nadahmed/IoTHomeAutomation/Report writing - Rough/pics/P_20171228_032329.jpg

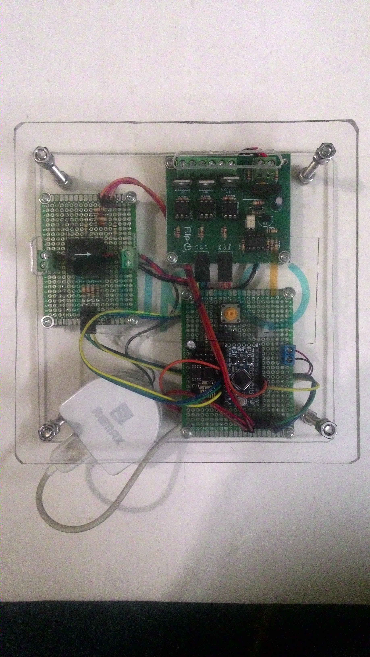
Report writing - Rough/pics/P_20171228_032329.jpg
