nadahmed/IoTHomeAutomation/499A/Project-Proposal-Updated (22nd Aug, 2017).docx

Department of Electrical and Computer Engineering

North South University

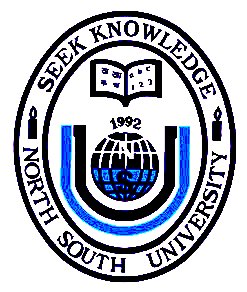
[picture p10: figure]

Senior Design Project

Home Automation System using Zero-Crossing detectors and Thyristor based Power Converter integrated with the world-wide-web and an Android app.

Noor Al Din Ahmed ID# 1310607043

Rahatul Aine ID # 1220812042

Faculty Advisor:

Tanzilur Rahman (Tnr)

EEE499A

Section: 05

Summer, 2017

Project Proposal

Title:

Home Automation System using Zero-Crossing detectors and Thyristor based Power Converter integrated with the world-wide-web and an Android app.

Abstract:

In today’s world everything is becoming modernized and almost everything is being controlled electronically and wirelessly. Keeping with the trend the world at present is seeing increased amounts of automation in homes. Home automation usually signifies increased automation of household appliances through electronic means. Although it is not as expensive as it used to be it is still quite costly and for that it has not been implemented at all in a developing country like ours. Hence we took on task of making a project which would involve automation of homes at a reasonable price with parts that are available within our country. Our project purpose is to build a unit that can monitor and control the electrical home appliances from anywhere in the world using a hand held mobile device. Nowadays, more and more people are getting easy access to the internet using a just simple handheld mobile device. And using it and the power of the internet, people can always keep tabs on what appliances are running, what is the condition of a room and how much power is being consumed in that particular room, all in real time. In doing this project would be using concepts of microcontrollers, sensors, telecommunications and embedded programming.

Aim and Objective:

Our aim is to build a home automation system that will improve comfort, enhance accessibility, minimize operating costs, simplify use of technologies, and promote energy efficiency and convenience. We aim to build a system that will enable people who are out of their homes most of the time to monitor their homes in real time from anywhere in the world. Also the physically challenged people can easily control basic appliances through an already available cell phone using an application. Our system can be used in hospitals to manage certain room conditions.

Motivation:

Home automation results in a smarter home and is used to provide a higher and healthier standard of living. The beauty of home automation system is that it is highly scalable, flexible, easy to use and its capabilities are limited only by our imagination. The system will be integrated with other IoT devices and our motivation is to facilitate the users to automate their home having remote access to the appliances and allowing home security.

Current status:

Home automation is currently being used at thousands of homes if not millions, mostly popular in western civilizations. So far, the most popular way of implementing a home automation system is by using microcontrollers and AVRs for the processing part and Dual Tone Modulation Frequency (DTMF), Bluetooth, GSM, RF based controllers such as Zigbee or XBee, WI-FI or Ethernet. Of which few of them are operated through cloud based computing connected to the Internet of things (IoT). Their functionality and focus are in certain fields such as controlling door locks, detecting human presence, controlling various household appliances and providing various security features.

Plan of work:

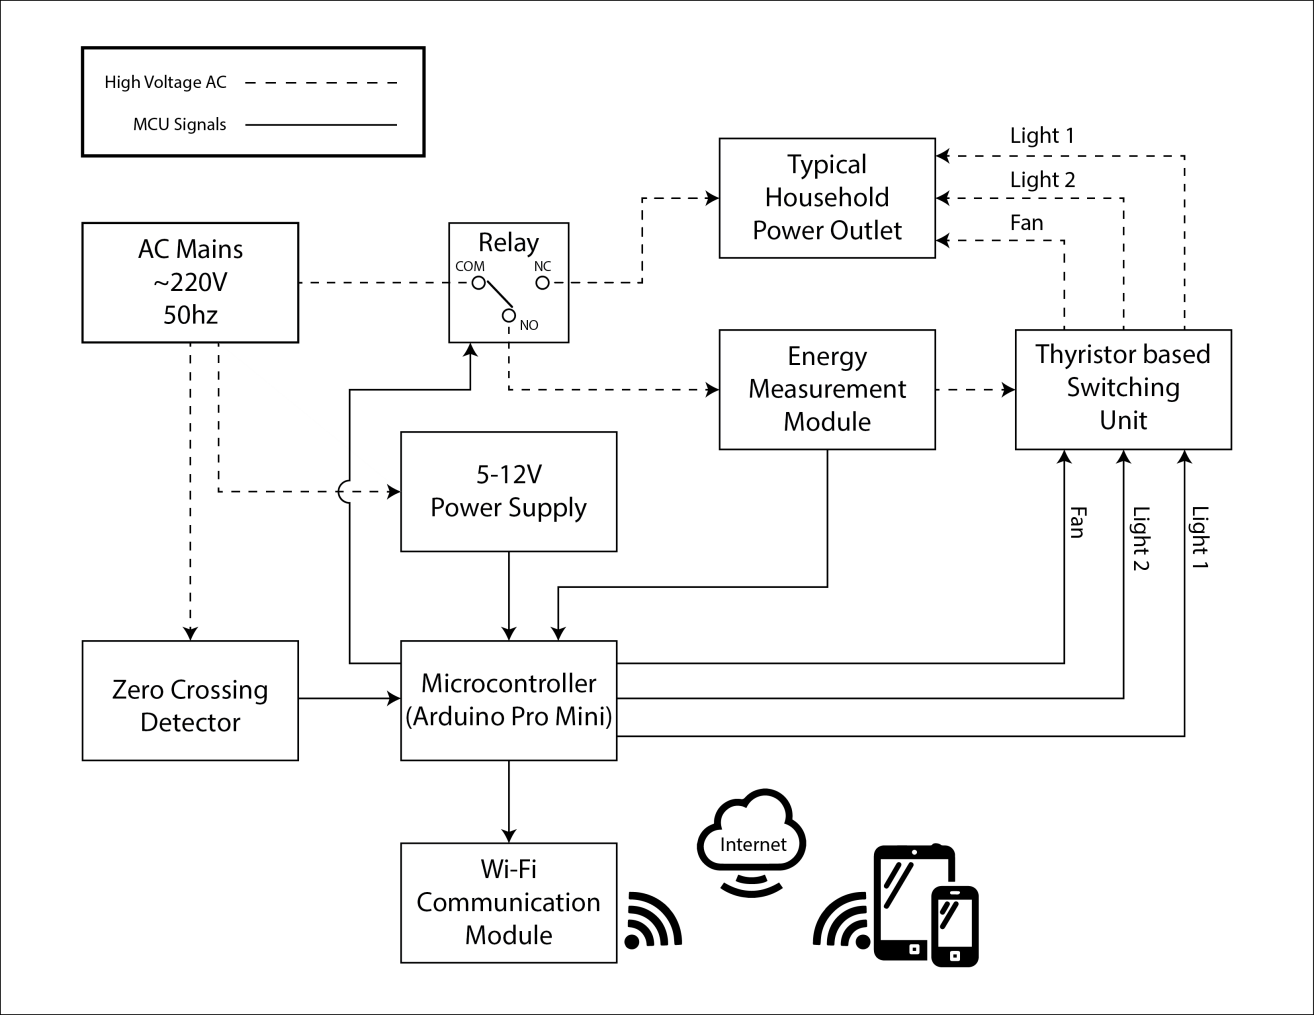
[picture p11: figure]

Figure 1: The home automation unit block

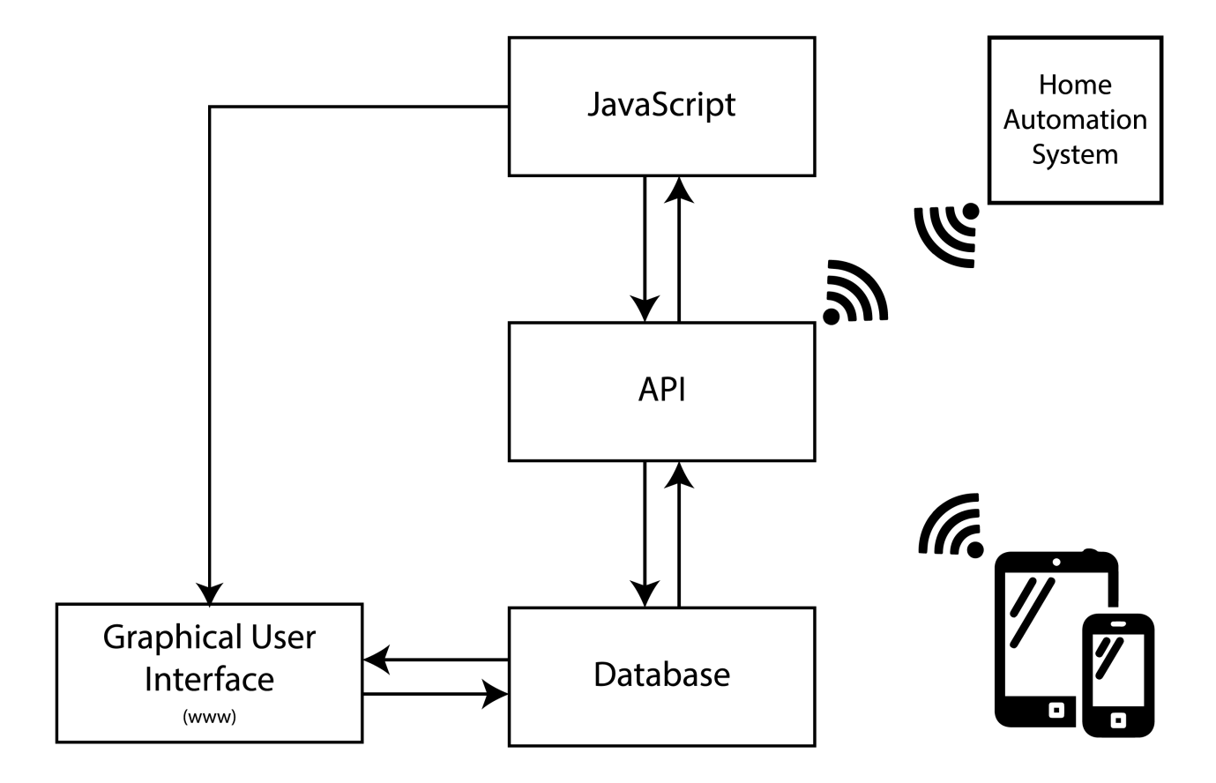
[picture p12: figure]

Figure 2: The internet block

The device will be controlled through Wi-Fi in an indoor network hub that is connected to the internet. The system will be connected as follows: There will be a relay separating the Home Automation System from the traditional power outlet, so that we can switch between the traditional outlet and HAS anytime. The power outlet will be connected to the “Normally Closed” pin of the relay so that even if the HAS is turned off or not working the user can still use the traditional system. At “Normally Open” condition the HAS will be activated and the microcontroller will detect the phase of the AC signal through the Zero Crossing Detector (ZCD) and control the conduction cycle of the AC signal on the output of the Thyristor based switching unit. With the help of a ZCD, users can regulate the amount of power to output to the lights and Fan through the unit, besides having the capability of completely switching them on and off. The user will also know how much power is being consumed. The microcontroller will be connected to the user’s home internet connection through Wifi and the controller can communicate with a web browser over the internet. The client request will be sent to the arduino web server (microcontroller) through web browser and then the arduino server will send back the HTTP response to the browser and serve the client’s request which will be displayed on GUI. The device can be controlled from anywhere around the world using an Android mobile application or an internet activated device.

In order to make a web based Home Automation system, the following tasks need to be done:

Software:

1. Learning about Django Framework – At the beginning, we will learn the basics of how the Django Framework works.
2. Database – we will gather general idea about working on database, we’ll learn to create basic SQLite3 statements in Django and then we will practice making a simple database.
3. Web Development – we will learn the essential coding skills needed to develop web applications. We will learn about HTML, CSS, basics of JavaScript which will be needed to built web application to implement with Django.
4. Web Server –We will try to make a simple web server with python. And based on the acquired knowledge, we will make a web server on home automation that will serve our purpose.
5. We will build an API using the Django Rest Framework, so that our unit and various other devices can communicate with each other through our server.
6. Test run – in the end, we will give the server a test run to check if it works according to our plan.

Hardware:

1. Simulating and Making the Zero crossing detector- Trying out various method for making a zero crossing detector and to analyse what works best for this application.
2. Simulating and making an energy measurement module using available ICs- Trying out different IC to measure the Real power, reactive power, apparent power, power factor and various other power related parameters.
3. Simulating and making the Thyristor based switching unit.
4. Programming the microcontroller to make the circuits on 1,2 and 3 work together and assemble a prototype to make sure everything is working correctly.
5. Establishing a connection between the microcontroller and the Wi-Fi module and start communicating with the web server.
6. Connecting everything and test running along with software part.
7. Learn Proteus to make a PCB layout and build the unit on a PCB printed circuit board for stability, longevity and reduced form factor.

Justification and novelty:

In the proposed system, it will focus on controlling the switching of the power outlets that can be used to control various electrical appliances, such as lights and fans or any inductive load that can be voltage regulated and/or switching various devices on and off and will also include a power consumption sensor. A Zero Crossing Detector and SCR based switching circuits will be used for this operation. This will ensure that there are no moving parts that are involved which also means, there will be few to no maintenance cost.

Milestones and time frame:

Software:

Tasks | Duration in week
Django Framework | 2
Database | 3
Web Development | 3
Web Server and API | 4
App Developement | 4

Hardware:

Tasks | Duration in week
Simulating and building ZCDs | 3
Simulating and making the switching circuit | 3
Building the Energy Measurement module | 3
Programming the microcontroller for testing | 2
Assembly of the whole unit | 3
Connecting the MCU to WiFi | 3
Integration with the WWW | 4
Test Run | 2
Troubleshooting and improvising | 3

Specifications of the product:

Specifications of the home automation system are given below -

- User can control their home appliances through their cell phone using an application/software.
- User will have real time data on how much power is being consumed on their mobile devices.
- Voltage regulation is possible through mobile application. For example: Dimming lights and speed regulation of a fan.
- Automatic ambient light monitoring and adjusting.
- The system can notify users how much power is being consumed in the room
- Appliances can be controlled from anywhere around the world.
- The unit can be implemented in an already existing traditional system.

Deliverables and beneficiary industry/sector:

Home automation system offers a variety of services and functions. This system is intended to deliver services to customers who have a large family or are a household of one, by making their life easier and saving their amount of labour, time and energy. Our plan is to build a home automation system that will be affordable to many users. This system will benefit users while they are leaving or returning to their home.

Tentative budget with year and item wise breakup:

The detail below is the breakdown of cost of items that will be used in our project and shows our project budget.

Item Name | Ratings | Quantity | Total
Microcontroller | Arduino Pro Mini | 1 | 180tk
Wi-Fi module | ESP-8266 | 1 | 250tk
Energy Measurement IC | ADE7758 | 1 | 200tk (aprox.)
Current Transformer | 1800:1 | 1 | 120tk
Vero boards | Strip Board 5x7cm | 2 | 180tk
Relay | SRD-5VDC-10A | 1 | 20tk
Passive Components | Various | - | 100tk
Triac | BT134 4A 500V | 10 | 50tk
Optocouplers | 4N35 | 2 | 50tk
Optocouplers | MOC3021 | 5 | 75tk
Wires | - | - | 100tk
Diodes | 1N-5819 | 10 | 100tk
Transistors | 2N3904 NPN | 10 | 30tk
SIL pins and connectors | various | - | 200tk
Total | | | 1655tk

This is a close but approximate budget for the end product. Prices of various tools, services and apparatus needed to build this project were not taken into account. Also, more budget may be required if parts gets damaged.

Conclusion:

This design will be highly demanding in the near future as our country is becoming a developed day by day and in that case everyone will become very busy with daily work. They will look for more security and comfort. This design will be simple and affordable for families from lower middle class to upper middle class. Since the main concept is simple, it takes less time to understand the concept and one can devote more time on future developments or adding extra features to this design.
