nadahmed/IoTHomeAutomation/Limitations notes.docx

Limitations:

- Commercially incandescent lights, the LEDs which are dimmable can work perfectly but CFL, LED that used different technology to light up won’t work.
- No security features been added to our web server yet, but work will be done for the next iterations. Since there is no authentication system, so server can be accessed by any user.
- This module is rated for 240V, 5A AC power systems only.

Future works:

- Security issues need to be sorted
- MOSFETS are becoming far more sophisticated nowadays and can be used for this purpose using the PWM method instead of phase controlled switching.
- Features such as, motion sensors, cameras, AI
- CFL will be replaced by LED. LED will be vastly used in future since it has several benefits, such as, consumes less power than CFL, environmentally friendly. Users mostly prefer to use this product.
- If any additional device which a user wants to use in its system, he can simply connect the device to the central unit to make it work (under his same username).
- We will be implementing power factor corrections for energy saving applications.
