nadahmed/IoTHomeAutomation/499A/Report Cover Page Style (Must be used).docx

Department of Electrical and Computer Engineering

North South University


Senior Design Project

Title

Name 1 ID #

Name 2 ID #

Name 3 ID #

Faculty Advisor:

Name

Details

Summer, 2017
