nadahmed/IoTHomeAutomation/499-05.png

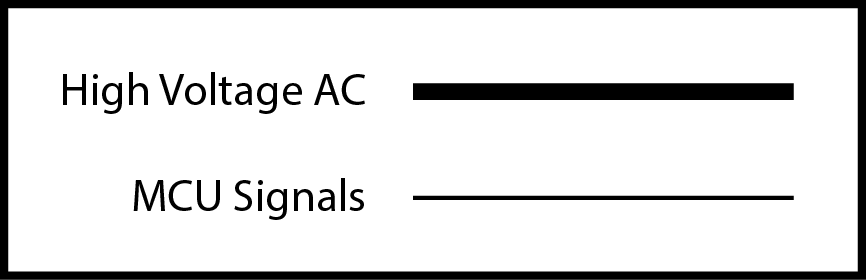
499-05.png
