nadahmed/IoTHomeAutomation/499A/3QcQz.png

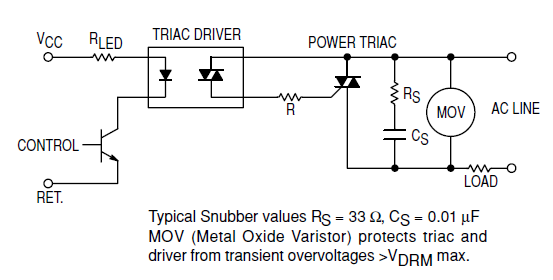
499A/3QcQz.png
