nadahmed/IoTHomeAutomation/499A/9535092200_1348606432_thumb.jpg

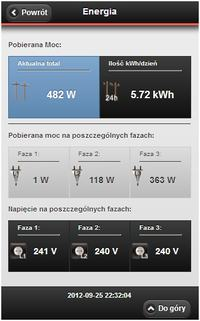
499A/9535092200_1348606432_thumb.jpg
