nadahmed/IoTHomeAutomation/499A/BMP/BK000003.BMP

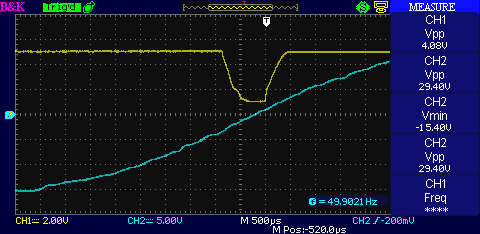
499A/BMP/BK000003.BMP
