nadahmed/IoTHomeAutomation/499A/BMP/BK000004.BMP

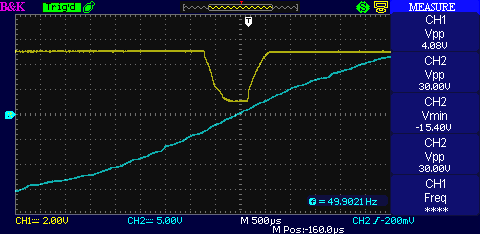
499A/BMP/BK000004.BMP
