nadahmed/IoTHomeAutomation/499A/BMP/BK000006.BMP

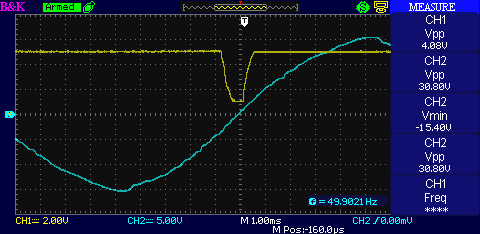
499A/BMP/BK000006.BMP
