nadahmed/IoTHomeAutomation/499A/BMP/BK000011.BMP

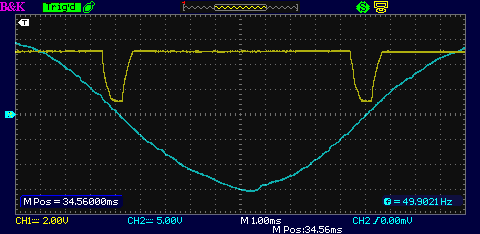
499A/BMP/BK000011.BMP
