nadahmed/IoTHomeAutomation/499A/flip-io.png

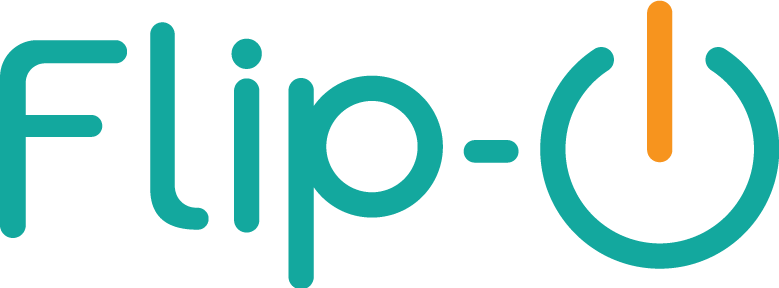
499A/flip-io.png
