nadahmed/IoTHomeAutomation/499A/Screenshot from 2017-08-26 23-30-59.png

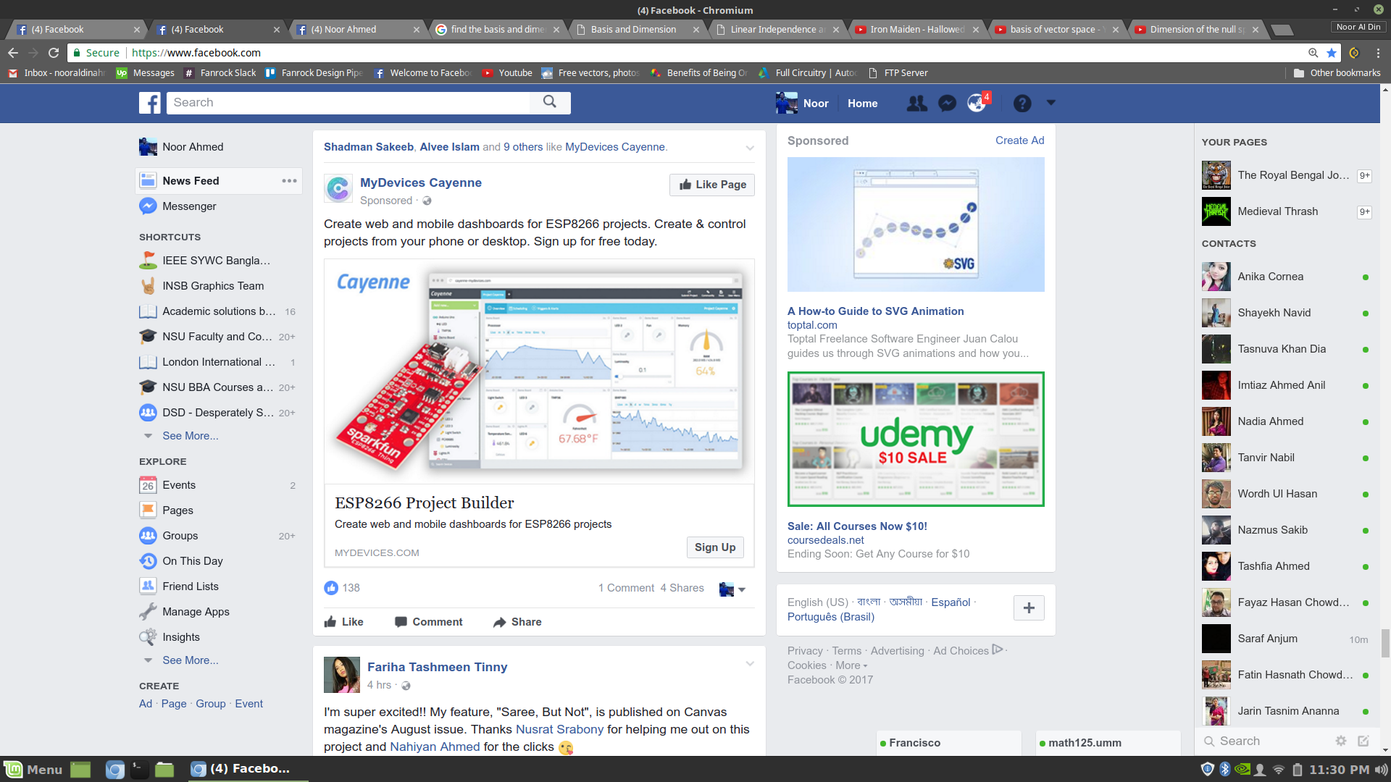
499A/Screenshot from 2017-08-26 23-30-59.png
