nadahmed/IoTHomeAutomation/499A/Untitled-1.bmp

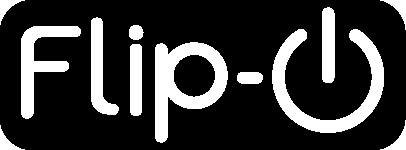
499A/Untitled-1.bmp
