nadahmed/IoTHomeAutomation/499A/voltage and current sensor/ADC.jpg

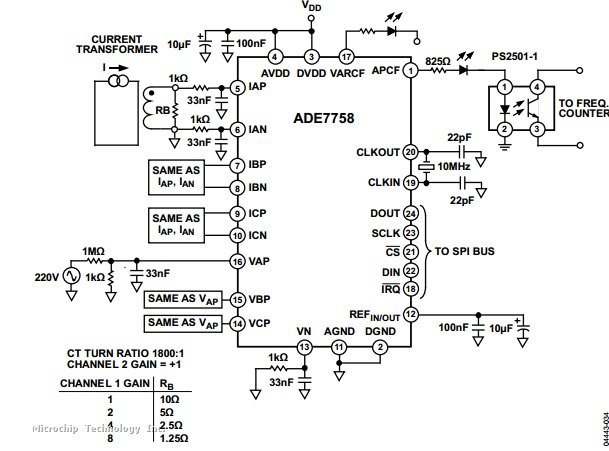
499A/voltage and current sensor/ADC.jpg
