nadahmed/IoTHomeAutomation/giphy.gif

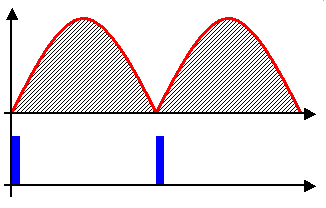
giphy.gif
