nadahmed/IoTHomeAutomation/Poster Ideas/68206_7093337_1385725_ee331039_image.jpg

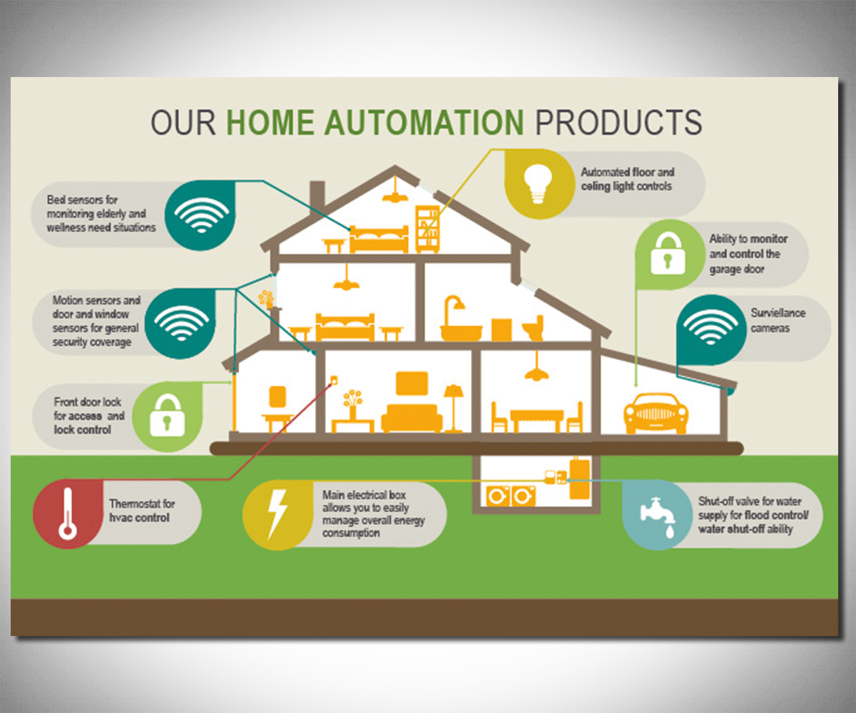
Poster Ideas/68206_7093337_1385725_ee331039_image.jpg
