nadahmed/IoTHomeAutomation/Poster Ideas/517097665.jpg

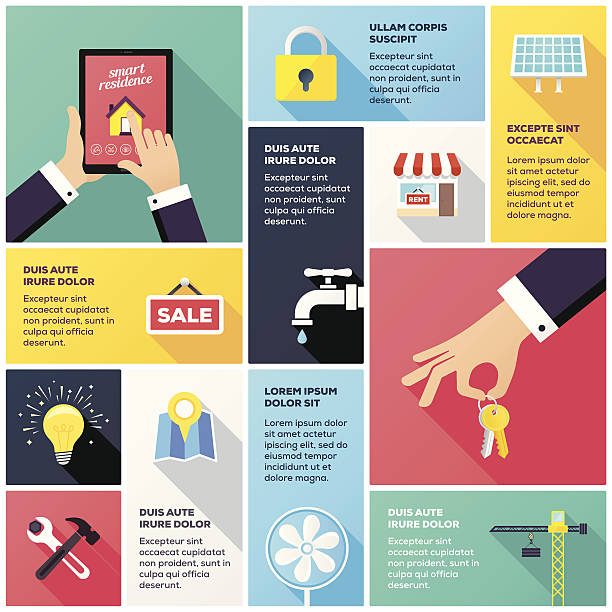
Poster Ideas/517097665.jpg
