nadahmed/IoTHomeAutomation/Poster Ideas/HOME-screen-26.jpg

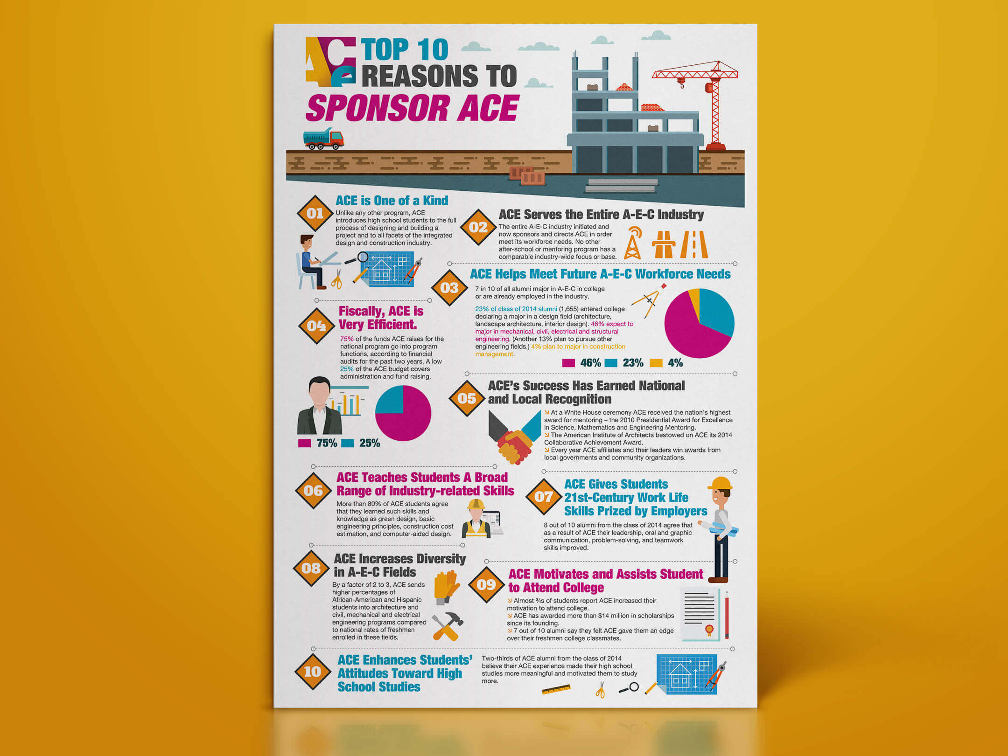
Poster Ideas/HOME-screen-26.jpg
