nadahmed/IoTHomeAutomation/Poster Ideas/images.jpg

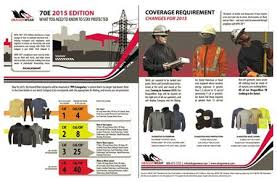
Poster Ideas/images.jpg
