nadahmed/IoTHomeAutomation/Poster Ideas/sittingkillingyou.jpg

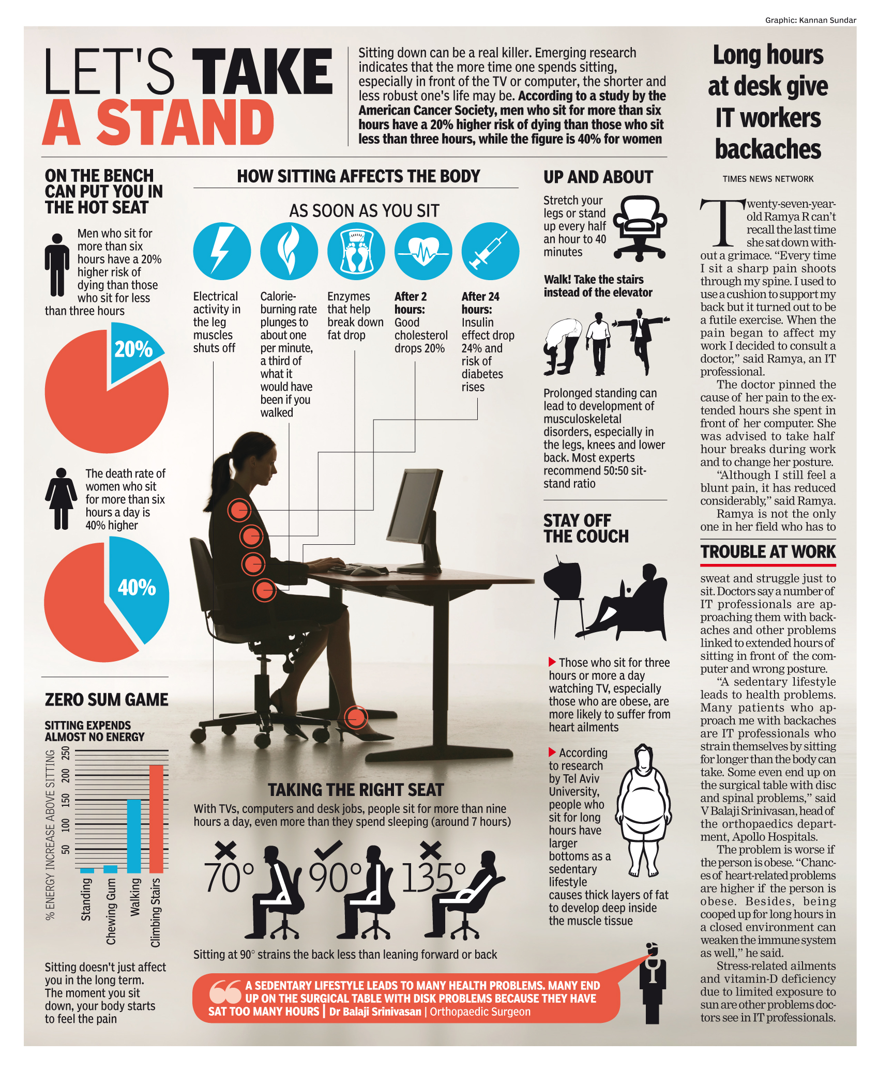
Poster Ideas/sittingkillingyou.jpg
