nadahmed/IoTHomeAutomation/Poster Ideas/stock-vector-detail-infographic-vector-illustration-world-map-and-information-graphics-summary-info-about-the-99100406.jpg

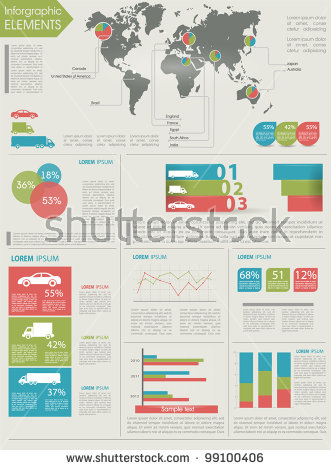
Poster Ideas/stock-vector-detail-infographic-vector-illustration-world-map-and-information-graphics-summary-info-about-the-99100406.jpg
