nadahmed/IoTHomeAutomation/Poster Ideas/stock-vector-professional-electrician-infographic-template-with-colorful-electrical-tools-devices-and-elements-563759542.jpg

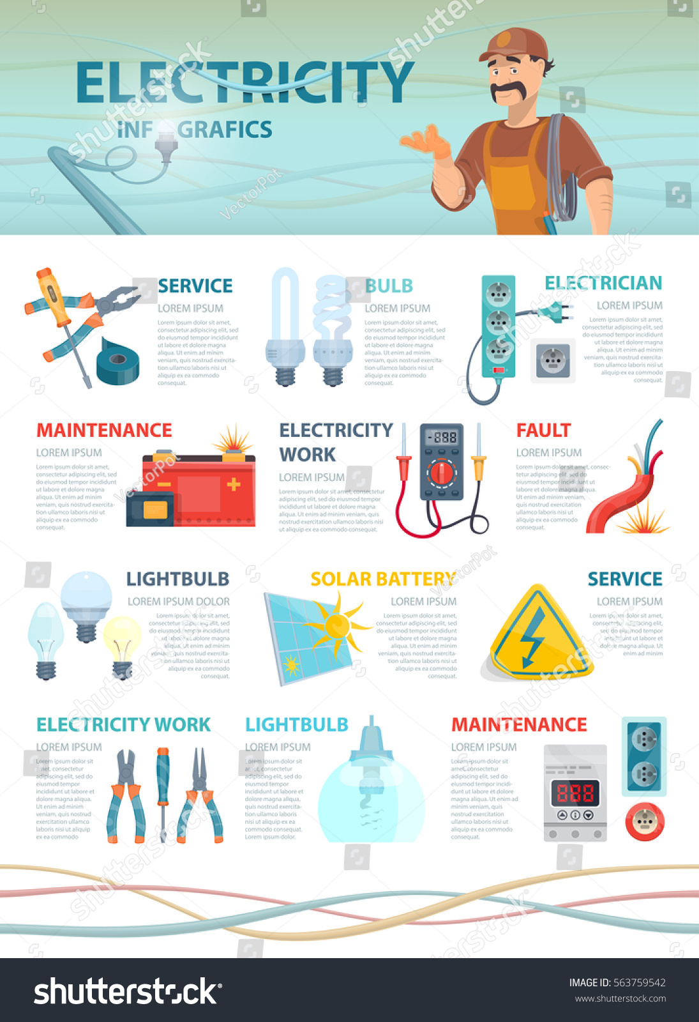
Poster Ideas/stock-vector-professional-electrician-infographic-template-with-colorful-electrical-tools-devices-and-elements-563759542.jpg
