nadahmed/IoTHomeAutomation/Poster stuff/25498328_2032381020310249_6357326843880528299_n.jpg

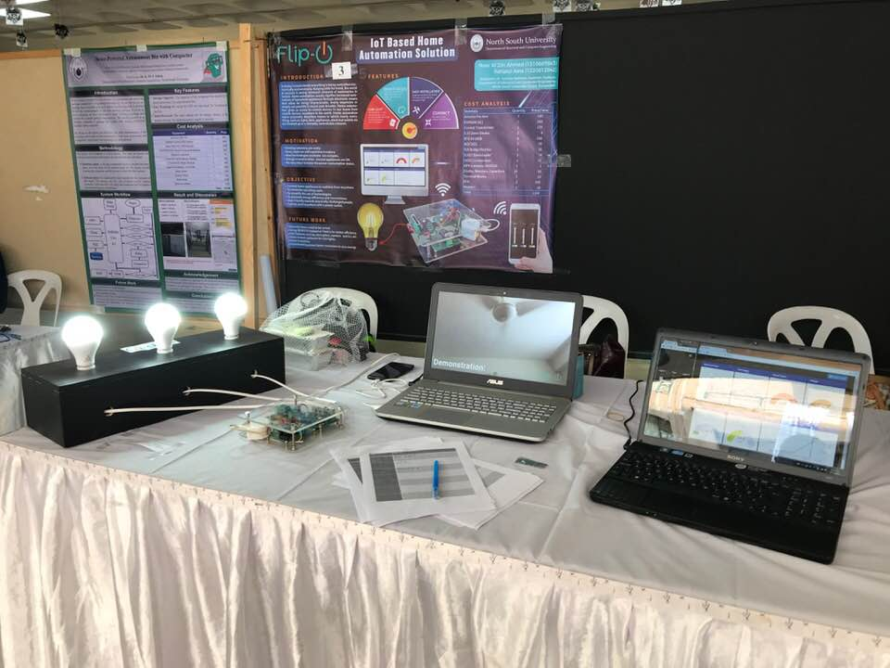
Poster stuff/25498328_2032381020310249_6357326843880528299_n.jpg
