nadahmed/IoTHomeAutomation/Poster stuff/bulb.png

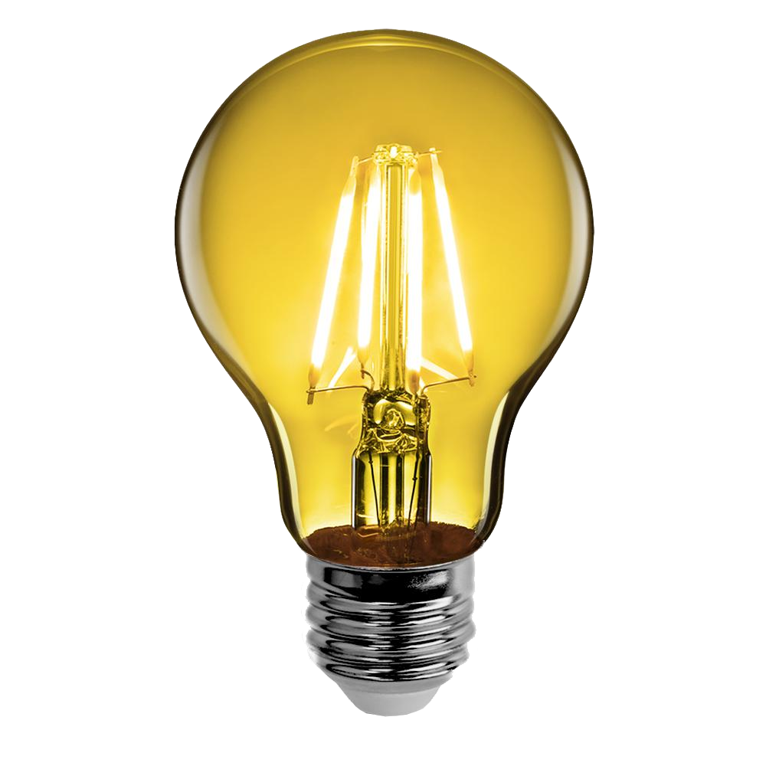
Poster stuff/bulb.png
