nadahmed/IoTHomeAutomation/Poster stuff/Capstone poster-02.jpg

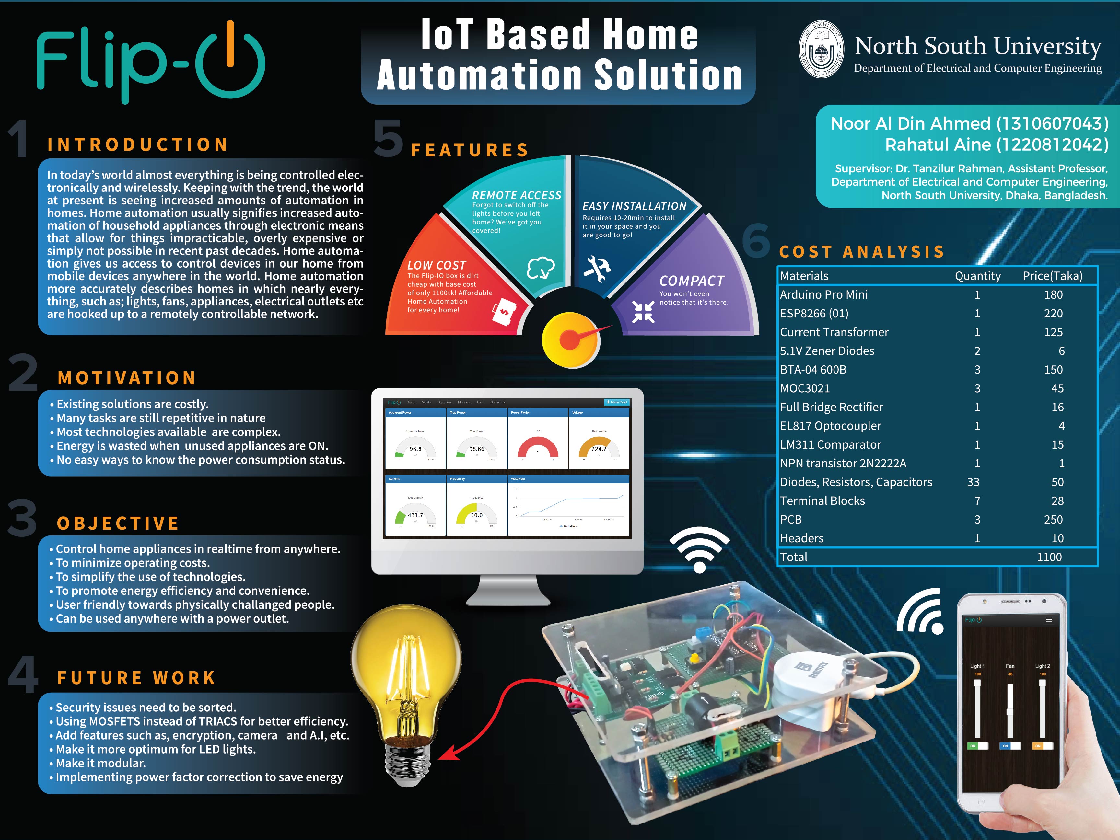
Poster stuff/Capstone poster-02.jpg
