nadahmed/IoTHomeAutomation/Poster stuff/flipiohand-white.png

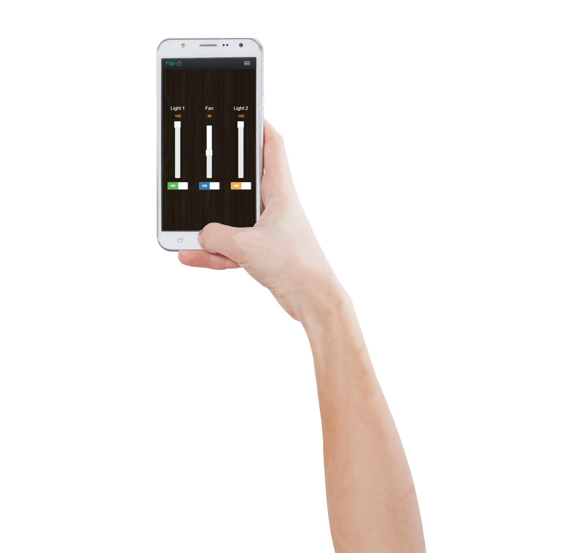
Poster stuff/flipiohand-white.png
