nadahmed/IoTHomeAutomation/Poster stuff/flipiohand.png

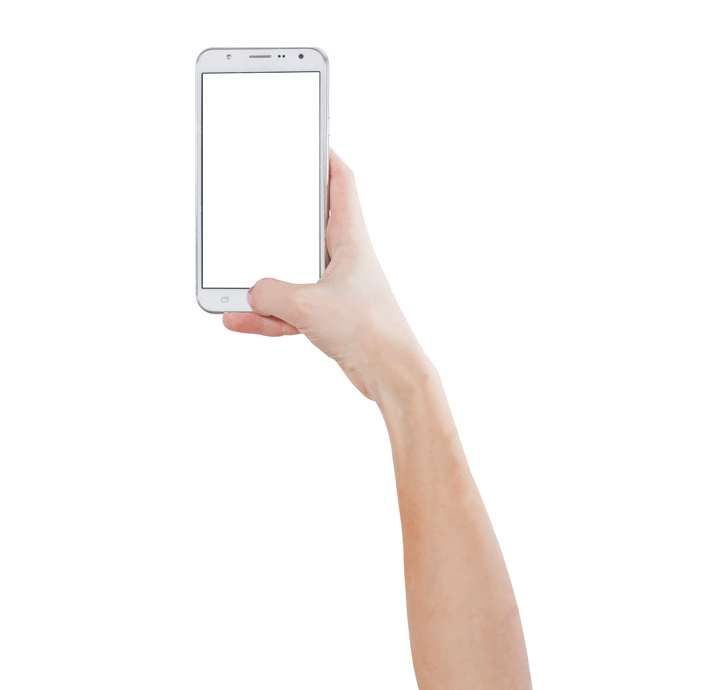
Poster stuff/flipiohand.png
