nadahmed/IoTHomeAutomation/Poster stuff/lg-g6_square-camera-flip.png

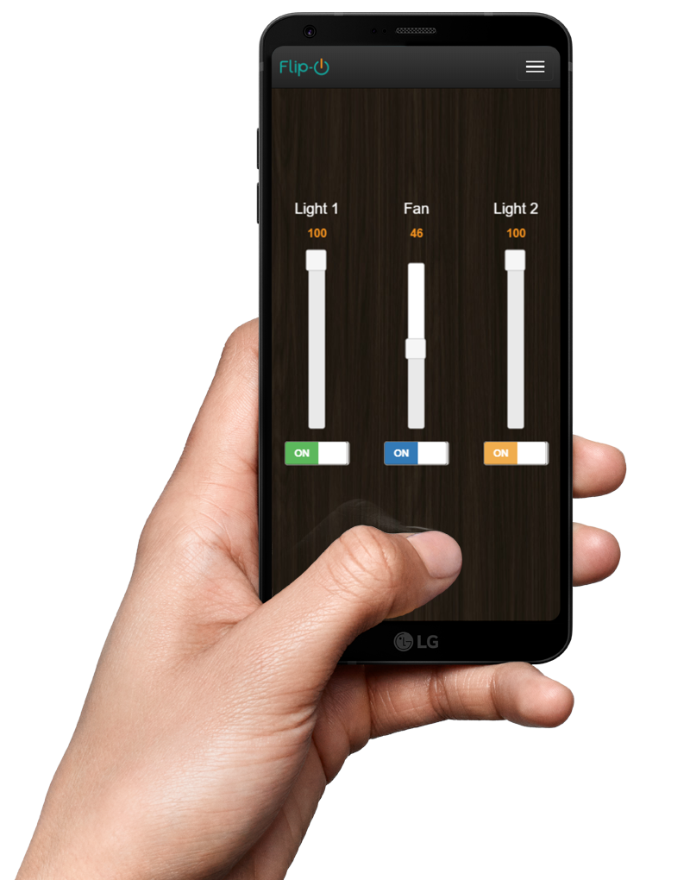
Poster stuff/lg-g6_square-camera-flip.png
