nadahmed/IoTHomeAutomation/Poster stuff/lg-g6_square-camera.png

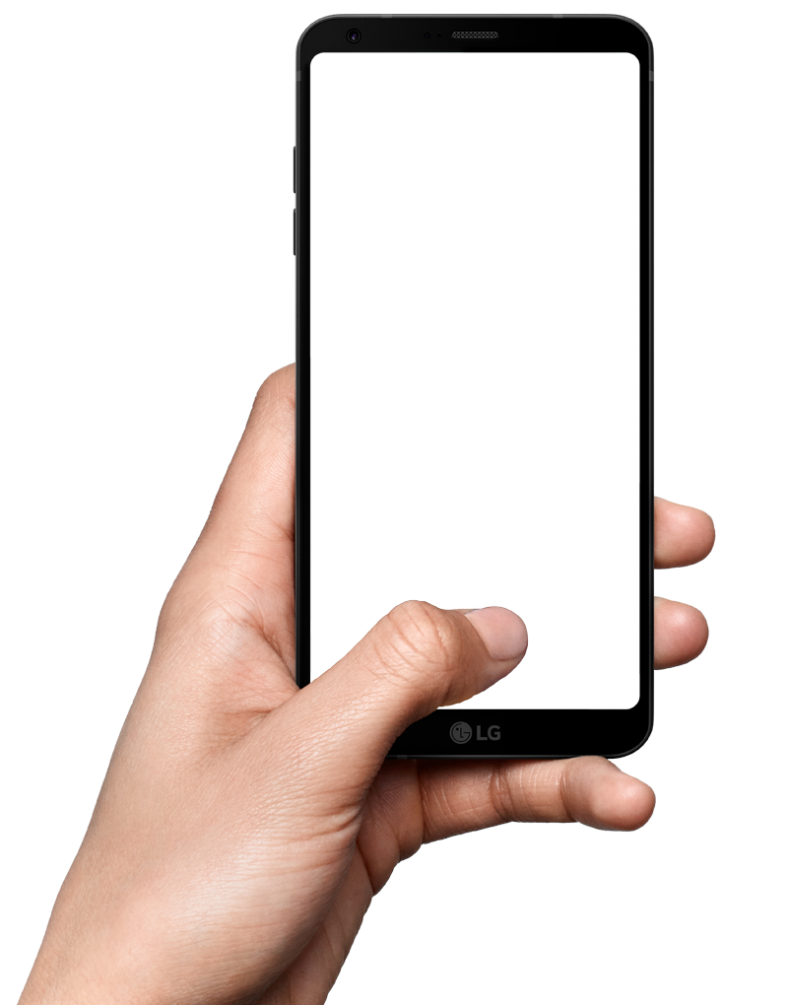
Poster stuff/lg-g6_square-camera.png
