nadahmed/IoTHomeAutomation/Report writing - Rough/pics/P_20171228_032458.jpg

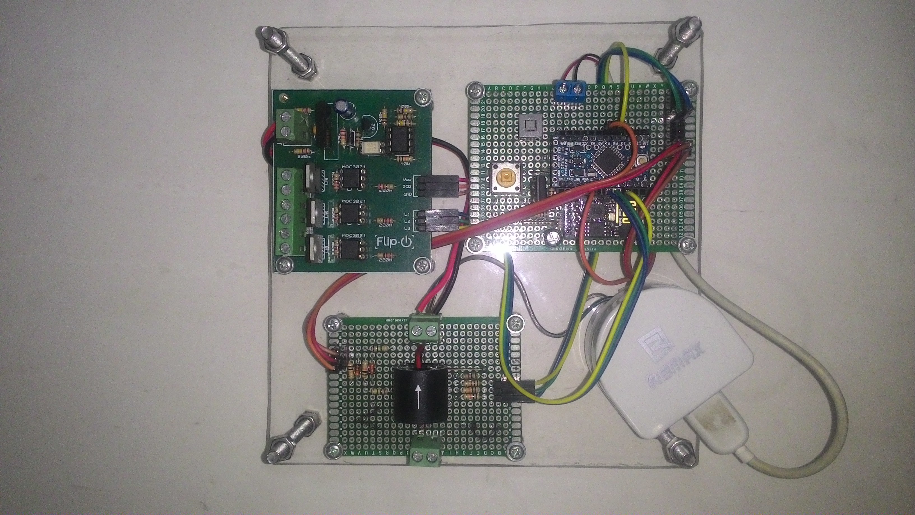
Report writing - Rough/pics/P_20171228_032458.jpg
