nadahmed/IoTHomeAutomation/Experiment Data Sheet.xlsx

R = 500-600ohms |  | XL = 500-600ohms
Vin(rms) | Thyristor firing (%) | Vout (Graph) | Vrms | Voltmeter | I (graph) | Irms | Ammeter | Interface Readings
230 | 0
230 | 10
230 | 20
230 | 30
230 | 40
230 | 50
230 | 60
230 | 70
230 | 80
230 | 90
230 | 100
Avg Request - Response time
Zero Crossing Detection
No. on Crossing | Real Zero | Detected Zero | Real - Detected Zero | Output Graphs
1
2
3
4
5
6
7
8
9
10
