nadahmed/IoTHomeAutomation/Poster Ideas/reasons-for-regular-solar-pv-testing.jpg

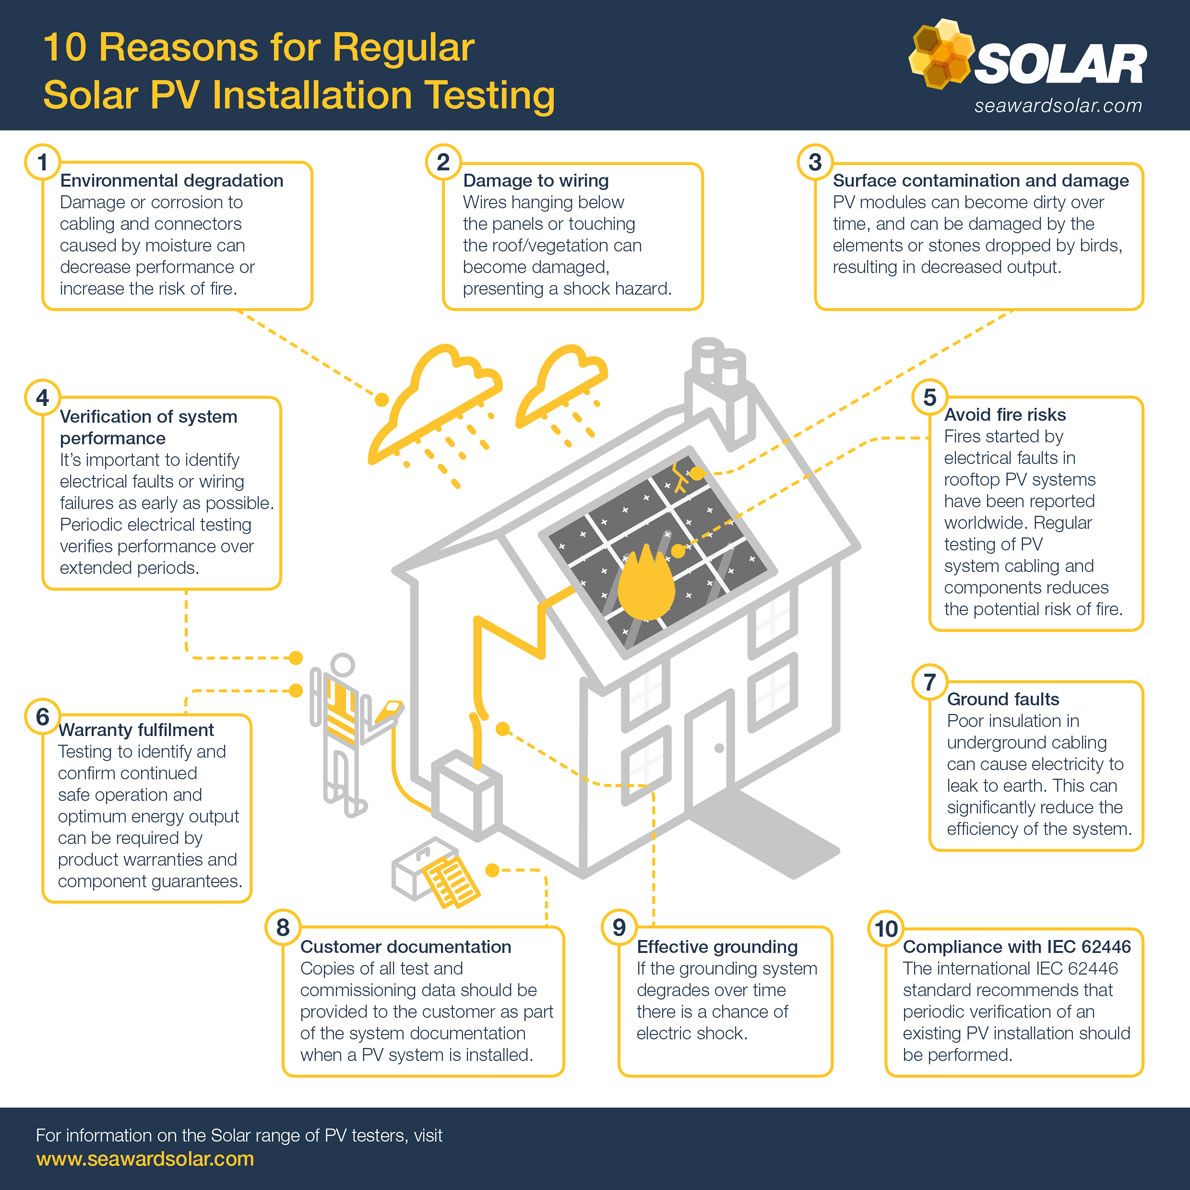
Poster Ideas/reasons-for-regular-solar-pv-testing.jpg
