nadahmed/IoTHomeAutomation/(list of files, drawings)

Other design files:
499A/flipio.pdsprj
Report writing - Rough/Codes/Codes and schematics/Proteus Files/Voltmeter.pdsprj
Report writing - Rough/Codes/Codes and schematics/Proteus Files/ZCD and TRIACS.pdsprj
